dekuNukem/bob_cassette_rewinder/resources/pics/DSCF0456.jpeg

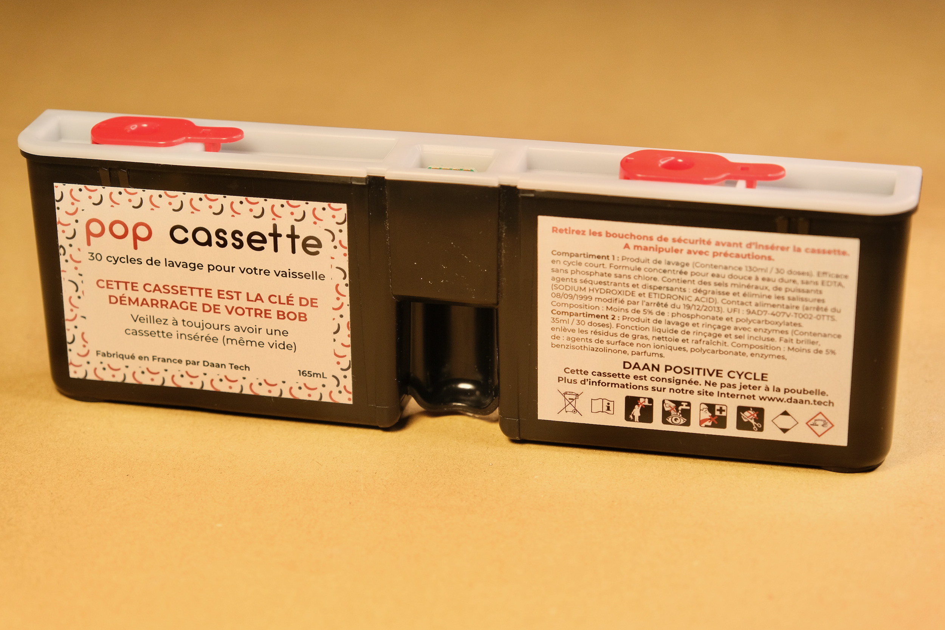
resources/pics/DSCF0456.jpeg
