dekuNukem/bob_cassette_rewinder/resources/pics/cost_2021.png

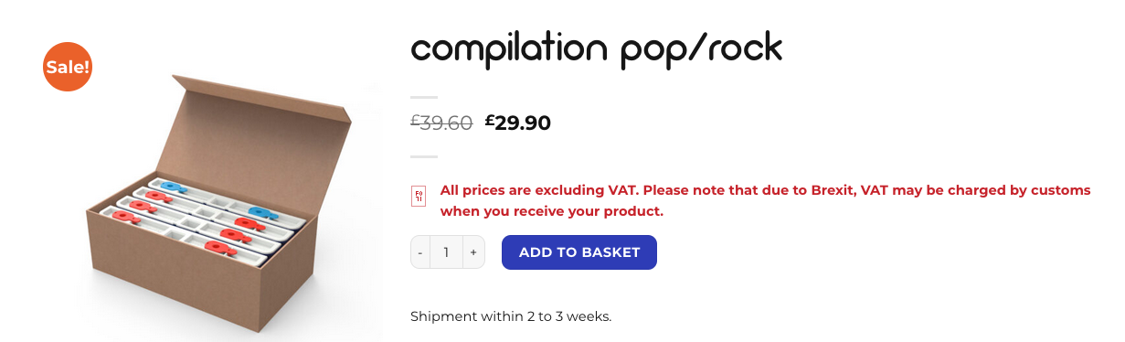
resources/pics/cost_2021.png
