dekuNukem/bob_cassette_rewinder/(threads)

Thread 3 (2021-04-30):

Did you consider writing an EEPROM emulator?

daantimmer, 2021-04-30:
Instead of creating a PCB to reset the EEPROM have you considered using a very small MCU which emulates the EEPROM read/writes while basically always returning the maximum number? That would reduce the number of connector inserts/removals by 50% because those PCB connectors aren't too wear resistant.

ncw, 2021-05-02:
Or maybe modify the board so it enables write protect on the EEPROM?

jangrewe, 2021-05-13:
The one big reason why i would not use any read-only/autoreset feature: you wouldn't know when to refill the casette. I think the current solution is actually the best way.

dekuNukem, 2021-08-09:
> Or maybe modify the board so it enables write protect on the EEPROM?

Well, if you do want to enable Write Protect on the EEPROM, I have tested it out and written a guide about it:

https://github.com/dekuNukem/bob_cassette_rewinder/blob/master/user_manual.md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

Thread 9 (2021-05-04):

Look into Silicon plug or equal to refill by the orginal filling ports

oiaohm, 2021-05-04:
There has been a lot of inkjet cartridge refill over the years.   Pushing hole repeatedly though with a needle with the one way membrane is going to cause it to fail lot sooner just like push the ink back though the foam with printer cartridges.

On inkjets you have the refill/factory fill port on the other side of the cartridge to the outlet normally.    From what I have see of videos/photo of the bob cassette  the two factory filling ports that are now fully plugged are in fact on the other side of the cartridge to the one way membrane and the electronics right out on the corners well away from the electronics.    I know its kind of scary to have to drill 2 holes to put in refill port plugs.   Yes from what I can see of the bob cassette when sitting in the machine the original filling ports will be up so leakage if plugs are not perfect is highly unlikely if they are converted by drilling into refill ports with silicon plugs inserted.

https://www.aliexpress.com/i/32841417076.html
Yes the refill port plugs for inkjet cartridges are mass made.   Yes its possible that if you have a inkjet refill store near that they would do the fitting of the plugs into a bob cassette.   Not like its going to need different drilling set up.  Just they will need to know where on the cassette are the valid locations to put the two holes and unless the cartridge has changed since the photos I can see the locations are really clearly marked as they did not even bother colour matching the closing ports plastic.

Other thing you will find is a cartridge will most likely have a max refill count before some part of it comes a risk to crack or other wise fail.    This is why its important to use refill ports and the like in attempts to make this as many cycles as possible.   Yes the refilling ports are likely to have a stronger band of plastic around it so when filling in the factory if the machine was a little off don't have a breakage.

 The cassettes are similar to inkjet cartridges<<  Yes the i2c DRM on these cassettes are the same as early drm inkjet cartridge.   Some early inkjet cartridges also do use the one way membrane before changing to foam.    So these cassettes are very much early drm inkjet cartridges just filled with dish-washing chemicals.    To be correct inkjet cartridges where the tanks are split from the printer head.  Yes the filling ports of the factory also being really simple to spot is another thing of historic thing of early inkjet cartridges latter generations of inkjet cartridges where they started getting smart with their chips and hiding the correct refill ports.

This could turn into a wacky side job for a shop that does inkjet refills making bob cassettes properly refillable.

lechercheur123, 2021-05-05:
Hi everyone !

I also have a Bob dishwasher (in France ;) ), and I'm not very fond of poking through the silicone plug with a syringe.

I looked at my Bob cassette, and the silicone plugs can be easly removed with fingers (and maybe with gloves for safety) :

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

So I guess you do not need to use specific silicone plug to do what you want

I also found 2 other ports (maybe original refill ports ?), but I broke my nail trying to open one of them :) :

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

dekuNukem, 2021-05-05:
Nicely spotted, I didn't realise that the one-way membrane can be taken off. This certainly makes refilling the cassette easier, although I feel that the same part probably won’t survive many times of removal and insertion, so keeping it in place might make the cassette last longer.

Just a side note, in your photo, it seems that you put the detergent (yellow) in the left tank and rinse aid (blue) in the right, I think it's supposed to be the other way round, or maybe the colour of your detergents is just different? 🤔

lechercheur123, 2021-05-05:
It's very easy to remove the silicone membrane. I don't think removing it hurts the membrane very much.
But you are probably true. This membrane can't last forever. but I think it can last at least 20 or more refilings.

It's an unmodified Bob cassette, so 2 possibilities:
- They use differents detergents
- They mixed things up...

lechercheur123, 2021-05-05:
Side note:

After each wash, the detergent left white stains everywhere in Bob. Do you have the same thing ?

If no, it can be caused by the Bob cassette if detergent and rinse aid are switched

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

dekuNukem, 2021-05-05:
I just tried taking the memberine offI just tried taking the membrane off, it was pretty easy, but I did have to use a pair of pilers to get a better grip. Taking it on and off does seen to put a lot of stress on it though, so I still feel that it won’t last as long compared to “needle poking through membrane” method. The dishwasher itself has hoses poking though it, and they are much bigger.

I looked at a brand new unmodified cassette and drew out some liquid with a syringe. It was indeed a thick blue gel on the left tank, and a clear liquid detergent on right. You can even see the blue colour through the memberine. Not sure why your cassette is the other way 😅 maybe check the others if you have more.

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

As for the water stains, I have some on my lid too after a wash, I think it’s just from hard water.

lechercheur123, 2021-05-05:
> I just tried taking the membrane off, it was pretty easy, but I did use a pair of pilers to get a better grip. Taking it on and off does seen to put a lot of stress on it though, so I still feel that it won’t last as long compared to “needle poking through membrane” method. The dishwasher itself has hoses poking though it, so it should handle a much smaller needle.

I will try both methods when I will have to refil my cassette (I ordered your "rewinder" ;) ). I don't have a syringe yet to "evaluate" the stress it can cause.

> I looked at a brand new unmodified cassette and drew out some liquid with a syringe. It was indeed a thick blue gel in the left tank, and a clear liquid detergent in right. You can even see the blue colour through the memberine. Not sure why your cassette is the other way 😅 maybe check the others if you have more.

I only have one cassette. I will send a little mail to Daan to be sure :)

> As for the water stains, I have some on my lid too after a wash, I think it’s just from hard water.

You are probably right, I have a quite hard water here (588 µS/cm)

oiaohm, 2021-05-08:
lechercheur123  Yes those white hard to remove ports on the back I would suspect would be the original designed location for refilling.   Because that is exactly where they would be if you were using the patent for the early printer cartridges mirrored to make this cartridge.   This item does not look like a new design to me but a old design reused.

It's normal, we changed the formulae  <The common translation to that with ink-jet cartridges was:  "We buy what ever we think is the cheapest that works for us"  I would suspect the same.   Yes this was bad with ink-jet printers when the swapped ink resulted in the complete print fading out of existence in 3 months because of the change.   So refilling yourself may be way to getting more dependable results here.

Yes removing the silicone membrane will shorten it life.

I would be guessing when Daan Tech refils they remove the silicone membrane refill and throws it away and gets a new one.  Not that environmentally friendly.   The fact the design has those extra ports sealed off if they are drill able and plug able that could be the better refill point.

 dekuNukem  I would say if they are drill able and plug-able would be testable on the cartridge you have already cut up so far.

Yes if filling by the silicone membrane by needle or by pulling them out will need new membranes sooner than if you are able to open a the two back ports and turn them into refill ports.

Thread 10 (2021-05-05):

Using an Arduino to reset the counter?

DDanielH, 2021-05-05:
Hi, is it possible to use an Arduino to write the counter on a cassette and if yes are you planning on writing some kind of tutorial?

rubyFeedback, 2021-05-06:
Would be useful to know; I guess the corporations will try to desperately counter the civil rights-to-repair movement, so information in this regard is super-helpful in the long run. And Arduino's are quite accessible even for semi "Average Joe's" (give or take).

dekuNukem, 2021-05-06:
Of course! It's just a bog standard EEPROM inside, and you can use any arduino to read and write it.

Here's a tutorial on sparkfun: https://learn.sparkfun.com/tutorials/reading-and-writing-serial-eeproms/all

dekuNukem, 2021-05-06:
The PCB plugs into a USB-A female socket just fine:

https://raw.githubusercontent.com/dekuNukem/bob_cassette_rewinder/master/resources/pics/pmm.jpeg

the pinouts are, from left to right in that photo on the USB socket, VCC, SDA, SCL, GND

HenrikBiscuit, 2021-05-07:
What will be the easiest way to write to your cassette, if you don't want to take the chance with the import duties from the UK? :D

DDanielH, 2021-05-07:
I hope this is not to mutch to ask, but do you have some example code on how to write the byte at address 0xa1? If i get this right: theoretically I just need to access the EEPROM via i2c and write 0x4e at address 0xa ?

dekuNukem, 2021-05-07:
this should be a decent tutorial: https://microcontrollerslab.com/24c04-two-wire-serial-eeprom-interrfacing-arduino/

A0, A1, A2 are all grounded on bob cassette's EEPROM, so the address should be 0x50.

Someone in the [discord chat](https://discord.gg/gyGFqD2vfP) got it working with an Arduino, so maybe you can try asking there as well.

Thread 11 (2021-05-10):

Commercial Dishwasher Detergent & Rinse Aid for EU Market / German Market?

Xearoxde, 2021-05-10:
Hello everyone,

does someone know where I can get dishwater detergent & rinse aid for the EU Market / German Market? On German Sites I find only b2b offers but nother for customers.

Maybe you know which dealer sells it for non-business customers.

Thanke you.

Xearoxde, 2021-05-12:
Thank you for sharing this. Maybe you can share your results from testing.

jangrewe, 2021-05-13:
I've ordered the Element-brand supplies from Xanchemie in Germany - straight from them instead of Amazon, to save on double shipping and also 5€ on the rinse aid.

http://shop.xanchemie.de/product_info.php?products_id=48
http://shop.xanchemie.de/product_info.php?products_id=46

Although still quite a bit more expensive than UK supplies, the dosage is perfect for the detergent and a bit too high for the rinse aid.

Melanoneiro, 2021-05-17:
@dekuNukem After reading through the conversations on your Discord server and here on github, I think it would be great to have a wiki page here listing detergents people have tried, where to buy them from and what results they achieved with them. If you like I could create a draft for that?

thisisthekap, 2021-06-10:
@dekuNukem @Melanoneiro Yes, that definitely would help a fortune!

PaulCarantonSNCF, 2021-06-10:
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

Hi,

I finally tested the deterged and rince aid I talked about earlier.

I knew that they was much more concentrated than the ones recommended by the author, so I diluted them by a factor 2. I mixed 65mL of detergent with 65mL of water, and I mixed 17mL of rince aid with 17mL of water.

[Security-info-detergent.pdf](https://github.com/dekuNukem/bob_cassette_rewinder/files/6632528/fiche-securite-EXE0312.pdf)
[Security-info-rinse-aid.pdf](https://github.com/dekuNukem/bob_cassette_rewinder/files/6632530/fiche-securite-EXE0314.pdf)

The results was not very good. I had a lot of white powder on my pans after a wash. I guessed it was due to a too high concentration of detergent.

So, I removed 30mL of the detergent mix and replaced it with water. The new mix is now a 1:2.67 dilution ratio of the "pure" detergent.

I don't have white powder on my pans anymore, so I guess 1:2.67 dilution ratio is the good one. For the moment, I will stay with 1:2 dilution ratio for rince aid.

If I do the calculation, it means that my detergent tank will last 30 washes *5000mL / (130/2.67) = 3080 washes (or more than 8 years for 1 wash per day). For the rince aid tank, it's 30 washes  * 5000mL / (35/2) = 8570 washes (or more than 23 years)

If I throw out the rinse aid after 8 years (Is it still efficient after so much years ?), I would have spent 36€ including delivery for 8 years (and 3000 washes). It's 4,5€ per year, or 1,1 cent per wash.

Neat :)

Attention : This is still a WIP. I need to test my dosages for a long time before being sure they are good. Also, for the record, I have a quite hard water at home (Conductivity à 25°C = 629 µS/cm or French TH = 35)

lechercheur123, 2021-06-10:
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

Hi,

I finally tested the deterged and rince aid I talked about earlier.

I knew that they was much more concentrated than the ones recommended by the author, so I diluted them by a factor 2. I mixed 65mL of detergent with 65mL of water, and I mixed 17mL of rince aid with 17mL of water.

[Security-info-detergent.pdf](https://github.com/dekuNukem/bob_cassette_rewinder/files/6632528/fiche-securite-EXE0312.pdf)
[Security-info-rinse-aid.pdf](https://github.com/dekuNukem/bob_cassette_rewinder/files/6632530/fiche-securite-EXE0314.pdf)

The results was not very good. I had a lot of white powder on my pans after a wash. I guessed it was due to a too high concentration of detergent.

So, I removed 30mL of the detergent mix and replaced it with water. The new mix is now a 1:2.67 dilution ratio of the "pure" detergent.

I don't have white powder on my pans anymore, so I guess 1:2.67 dilution ratio is the good one. For the moment, I will stay with 1:2 dilution ratio for rince aid.

If I do the calculation, it means that my detergent tank will last 30 washes *5000mL / (130/2.67) = 3080 washes (or more than 8 years for 1 wash per day). For the rince aid tank, it's 30 washes  * 5000mL / (35/2) = 8570 washes (or more than 23 years)

If I throw out the rinse aid after 8 years (Is it still efficient after so much years ?), I would have spent 36€ including delivery for 8 years (and 3000 washes). It's 4,5€ per year, or 1,1 cent per wash.

Neat :)

Attention : This is still a WIP. I need to test my dosages for a long time before being sure they are good. Also, for the record, I have a quite hard water at home (Conductivity à 25°C = 629 µS/cm or French TH = 35)

KleBoR, 2021-07-07:
hi, any news about the mixtures and/or other products?

Xearoxde, 2021-07-07:
> hi, any news about the mixtures and/or other products?

I bought this:
http://shop.xanchemie.de/product_info.php?products_id=48
http://shop.xanchemie.de/product_info.php?products_id=46

and I don't have mixed them with water. I have very good results.

KleBoR, 2021-07-07:
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

Ah ok. just checked the specs. im just a bit unsure if the dilution. if bob uses 1.x ml of rinse aid per litre and the specs are about 0.1 to 0.5 ml it would be way too much.

thisisthekap, 2021-07-12:
@Xearoxde @KleBoR Has someone done the calculations already how many water we have to add to those to have proper concentration?

KleBoR, 2021-07-13:
@thisisthekap not until now :/

VVincentt, 2021-07-23:
I am in France too and I bought the same products as @lechercheur123 thanks to his recommendation. I do not dilute them and I just refill the cassettes with the pure product. I have very good results, maybe even better than with the original cassettes. The filter in Bob remains clean much longer. My water is very soft, though, as I have a water softerner installed.

I used the detergent in the Rock'n Roll cassette too and it did the job.

lechercheur123, 2021-07-23:
@VVincentt Glad to help you :)
I finished my first refiled cassette yesterday. I will try to use pure detergent too :) (but I have a quite hard water, with a TH around 30°f)

Joel44220, 2021-08-31:
Bonjour la communauté.
Je suis en France.
Je commence à recharger les cassettes.
Personnellement j'utilise les produits suivants  avec succès sauf le détartrant que je n'ai pas encore appliqué.
De plus je vous joins une copie de ma facture. Ce fournisseur est très sérieux, prompt et efficace.
[Facture produits lavage Bob.pdf](https://github.com/dekuNukem/bob_cassette_rewinder/files/7082185/Facture.produits.lavage.Bob.pdf)
[fiche-technique-DETX15.pdf](https://github.com/dekuNukem/bob_cassette_rewinder/files/7082186/fiche-technique-DETX15.pdf)
[fiche-technique-EXE0313.pdf](https://github.com/dekuNukem/bob_cassette_rewinder/files/7082187/fiche-technique-EXE0313.pdf)
[fiche-technique-EXE0314.pdf](https://github.com/dekuNukem/bob_cassette_rewinder/files/7082188/fiche-technique-EXE0314.pdf)

lechercheur123, 2021-08-31:
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

Bonjour Joel44220,

Merci pour ta contribution.

J'utilise les même produits, mais je les paye beaucoup moins cher en les achetant ici :

    detergent : https://eshop.medipost-nutristoma.com/produits/medical/desinfection-hygiene/liquide-de-lavage-exeol-pour-lave-vaisselle-5-litres.html
    rinse aid : https://eshop.medipost-nutristoma.com/produits/medical/desinfection-hygiene/liquide-de-rincage-vaisselle.html

Cependant, ils n'ont pas le détartrant dans leur catalogue.

Pour un bidon de 5L de détergent et de liquide de rinçage, j'en ai eu pour 36€, livraison incluse.

Hi Joel44220,

Thank you for your contribution.

I use the same product as you, but I found them somewhere else cheaper :

    detergent : https://eshop.medipost-nutristoma.com/produits/medical/desinfection-hygiene/liquide-de-lavage-exeol-pour-lave-vaisselle-5-litres.html
    rinse aid : https://eshop.medipost-nutristoma.com/produits/medical/desinfection-hygiene/liquide-de-rincage-vaisselle.html

But the limescale is missing on this website.

For a 5L bottle of detergent and 5L bottle of rinse aid, I paid 36€, including delivery.

bendardenne, 2021-08-31:
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

Attention que la facture contient ton adresse postale.

bendardenne, 2021-08-31:
> @Joel44220 @lechercheur123 @bendardenne
> Guys, could you please have the common decency to keep the conversation in the language that it started in? I'm also not a native english speaker, this is the internet, so please use the common language of the internet.

If you read down you will see that @lechercheur123's comment has an English translation at the bottom. As for my comment, it's addressed to Joel specifically as he (most likely unintentionally) leaked personal data.

I understand the sentiment but no need to be curt.

jangrewe, 2021-08-31:
@bendardenne: I said "please" twice, how's that rude?

lechercheur123, 2021-08-31:
>
>
> @bendardenne: I said "please" twice, how's that rude?

Well, in France saying "avoir la décence de" (tanslation of "have the decency") is quite offensive. But I understand this was not your intention.

I agree with you that this topic should stay in English (as in most forums). But @Joel44220 might not speak English (and he joined Github just before posting his message, so he might not be used to this "unspoken" rule).

That's why I wrote my message in both languages, in order to not offend anyone.

Joel44220, 2021-08-31:
Bonsoir,

Merci pour cette explication.
Je suis outré par ces réactions !!
Je me suis inscrit pour donner des compléments d'information pour les
pays francophones.
Je pensais dialoguer avec des gens respectueux, je me suis trompé.

Veuillez, dans les meilleurs délais, retirer toute trace de mon
intervention et me désinscrire de Github.

Très cordialement.
Joël OLLIVIER

Le Tue, 31 Aug 2021 04:45:15 -0700,
Paul ***@***.***> a écrit :

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

jangrewe, 2021-08-31:
Intentionally ignoring the now-not-unspoken-anymore rule after being asked nicely to make the conversation accessible to everyone, now *that* feels rude... but if my school french is sufficient, that problem will solve itself soon enough.

KleBoR, 2021-10-05:
@jangrewe have you managed the right concentration of those two xanchemie products?

gwynbleidddracke, 2021-11-12:
Hi @lechercheur123 the link are dead, did you have any other link with the same product ? i'm in France too and I struggle to find the good product. can you help me ?

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

PaulCarantonSNCF, 2021-11-13:
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

Hi @gwynbleidddracke !

Medipost changed their website. Here are the new links :
- detergent : https://www.medipost.shop/liquide-de-lavage-exeol-pour-lave-vaisselle-5-litres.html
- rinse aid : https://www.medipost.shop/liquide-de-rincage-pour-utilisation-en-machine-5-litres.html

lechercheur123, 2021-11-13:
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

Hi @gwynbleidddracke !

Medipost changed their website. Here are the new links :

    detergent : https://www.medipost.shop/liquide-de-lavage-exeol-pour-lave-vaisselle-5-litres.html
    rinse aid : https://www.medipost.shop/liquide-de-rincage-pour-utilisation-en-machine-5-litres.html

gwynbleidddracke, 2021-11-13:
Thanks for your help @lechercheur123 !
Now I know what to buy next month.

Thank you :)

KleBoR, 2021-11-21:
@Xearoxde how is it working with the pure rinse aid you bought?

What are you using for the rock&roll cartridge?

koffeinvampir, 2021-12-02:
>

I was wondering the same! The reset seems to work, but I have not found the composition of the de-scaler.

koffeinvampir, 2021-12-02:
> @Xearoxde how is it working with the pure rinse aid you bought?
>
> What are you using for the rock&roll cartridge?

I was wondering the same! The reset seems to work, but I have not found the composition of the de-scaler.

daveyijzermans, 2021-12-09:
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

So am I understanding correct that these two products are the perfect concentration for filling up the cassette? They don't need any additional preparing, diluting? I could buy these, fill up the cassette and use the rewinder?

LukasP, 2022-08-14:
I've been using the medipost detergent and rinse aid for a while now, it's not perfect but about as good as I remember from the original cassettes. I'll share what concentrations I use in case anyone's looking for another data point:

I use the detergent undiluted.
Manufacturer recommends 2.5-4g/L for my water hardness, Bob uses 4.33mL per liter, close enough imo.

For the rinse aid: 12mL rinse 23mL water
Manufacturer recommends 0.3-0.4g/L
Bob uses 1.17mL to 1.2L water, roughly 1g/L
I started with 2/5 or 14mL rinse 21mL water per refill, about 0.4g/L, which left some white residue.
Next refill used 12mL rinse to 23mL of water which should be about 34% or about 3.4g/L
White residue is almost gone but I remember getting a little of that with the original cassettes as well.

nyancrimew, 2022-08-19:
FYI for anyone from switzerland, while xanchemie doesn't list switzerland on their order form you can email them to order anyways, shipping is quite steep but not as bad as i expected

Thread 13 (2021-07-04):

Rock and Roll Cartridge, Tank 2

Hawk-v3, 2021-07-04:
While I can't find the EXACT product, my googlefu is failing me, the other tank appears to be something like this:

https://www.kiilto.com/product/f-60-ciro/#compositions

However the formulation doesn't match exactly, it has citric acid in it as well.

Dosage would be 35ml in a currently unknown amount of water.

The packaging details:
35ml/1 dose.
UFI: CM57-N0DW-W00G-D6CR
Composition: Methanesulfonic Acid

miyoyo, 2022-03-14:
Here are the exact specifications, you can use this website to get the formulation number:
https://www.decoder-ufi.com/ufi.aspx

The two formulations are:
 - Tank 1: P7D7-M0JG-G00K-AG7Q, Formulation 2670
 - Tank 2: CM57-N0DW-W00G-D6CR, Formulation 2593
Both are from SAS SODEL, www.sodel-sa.eu

When looking at the safety documents on the website, it appears that they use this specific format:

```
1.1. Product identifier
Product name : DPC 600
Product code : FS CLP2593.
```

So, looking for "FS CLP2670 filetype:pdf" gives us [this safety document.](https://www.avanteamgroup.com/docs/2621-4273-LIQUIDE%20VAISSELLE%20LLV200-.pdf)
Copy here: [2621-4273-LIQUIDE VAISSELLE LLV200-.pdf](https://github.com/dekuNukem/bob_cassette_rewinder/files/8246348/2621-4273-LIQUIDE.VAISSELLE.LLV200-.pdf)

So, the Bob Cassette Rock'N'Roll has:
 - Tank 1: [Sodel/Exeol LLV200](https://www.sodel-sa.eu/produit/EXEOL/LLV200/Liquide-Lavage-Vaisselle-eau-douce-a-dure-Ecolabel)
 - Tank 2: [Sodel/Exeol DPC600](https://www.sodel-sa.eu/produit/EXEOL/DPC600/Detartrant-Puissant-Concentre-Eco-optimise)

miyoyo, 2022-03-14:
And just because I can (sorry for the off topic part)

Pop Cassette:
- Tank 1: [Sodel/Exeol LLV300](https://ruedelhygiene.fr/wp-content/uploads/woocommerce_uploads/2020/09/Fiche-securite-LD2000S-awgfs5.pdf), ([Copy)](https://github.com/dekuNukem/bob_cassette_rewinder/files/8246394/Fiche-securite-LD2000S-awgfs5.pdf), 9AD7-407V-T002-0TTS, bleach based
- Tank 2: Not certain, however there is [this specific document in the safety sheets of Daan Tech](https://github.com/dekuNukem/bob_cassette_rewinder/files/8246424/FinalA_PSDS_D8168834-EU_Dish_Gel_2019_RTRID-11340.pdf), which refers to an off the shelf Finish All in One gel product, which is enzyme based.

Coincidentally, I was watching [Technological Connections](https://youtu.be/Ll6-eGDpimU?t=1580), which explains that Enzymes and Bleach do not mix in gels, which is probably why the cassettes are using detergent twice, and not something like dedicated rinse-aid.

dekuNukem, 2022-03-14:
Thanks! I'll add those information to the main articles.

hezibu, 2024-01-05:
Great work! Really appreciated.

Are the detergent specified by @miyoyo the final conclusion on what to refill each tank of the two cassettes?
That's amazing.

hezibu, 2024-01-05:
@miyoyo  Thanks for the quick reply.

I just got mine yesterday. I'm inclined for refills over tabs because I used to have tabs for my full size dishwasher, so I guess it's somewhat of an overkill with this small one.
How is your experience with tabs?

miyoyo, 2024-01-05:
You need to use different quantities depending on how hard your water is, I use a full tab myself

Thread 15 (2021-08-02):

Write protect on the EPROM

chiisai-fukurou, 2021-08-02:
Hi, I’ve looked at the documentation of the EPROM and saw that it has a write protect pin.

Did you try out connecting the WP pin to Vcc?

I want to try and connect the detergent tanks directly to the internal dosage pumps of bob to avoid having to refill the cassettes.
I’d still need the EPROM of the Cassette to get it to work tho.
So my train of thought is that Bob couldn’t modify the value on the EPROM anymore, reading the same number of cycles every time.

Also sorry if im getting things wrong… it’s been quite a few years since I worked on anything electronic :|

Thanks anyways :)

dekuNukem, 2021-08-09:
Here's the description of the write protect (WP) pin:

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

and here is how it is wired up on the circuit board:

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

You can see that it is connected to the ground plane UNDER the chip, which disables the write protect, allowing the EEPROM to be written to.

If you want to enable the WP again, you would need to either:

* Bend the pin upwards so it's not touching the pad, or...
* Desolder the chip, cut the connection to the ground plane, solder it back on

Then, you can connect that pin to VCC, which should then enable the write protect.

I haven't tried it myself, but it would be interesting to see what happens.

dekuNukem, 2021-08-09:
Good news! I have tested out the Write Protect, and it works! The wash count will be frozen, and Bob still works.

I have written a guide, check it out here:

https://github.com/dekuNukem/bob_cassette_rewinder/blob/master/user_manual.md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

bendardenne, 2021-08-09:
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

Excellent news ! I will try this with my current cassette once it runs out.

Couldn't they update the software to refuse the cassette if the eeprom cannot be written? I would probably disable over-the-air updates if I used this approach, what do you think?

dekuNukem, 2021-08-09:
It's definitely a good idea to keep it offline. There'ss no reason for a dishwasher to be online anyway, especially now it can be refilled! 😅

Thread 16 (2021-08-04):

Tindie's custom fees in the EU

bendardenne, 2021-08-04:
Hello,

First, thanks for all the work!

Unfortunately, Tindie's does not collect VAT at ordering, and so if you order from the EU you will (probably??) need to pay VAT yourself, along with hefty processing fees (I assume because of the new import rules that came in effect July 1st).

I don't know how easy it would be to find a platform which complies with EU VAT rules, but I think it would be good to mention this, here on GitHub and/or on Tindie's to avoid surprises for people like me who may not realize they are ordering from abroad :). Especially since a lot of people with Bobs are probably French.

I had to pay 21€ to the Belgian post in VAT and processing fees to receive the chip :(

dekuNukem, 2021-08-16:
Sorry to hear about the VAT fee, 21€ is a bit outreageous, that's almost the cost of this device!

Anyway, I have made some changes to the custom documents, and added more detailed decription of the product, hopefully it will make them happier.

bendardenne, 2021-10-08:
If I understood correctly, there's no amount of description that can bypass this, unfortunately. The shop would need to charge VAT and then somehow pay it back to "the EU" (I guess the destination country?? no idea how this works). Some info here: https://www.bpost.be/en/shopping-outside-eu

What's outrageous is that 15€ flat processing fee that bpost charges. For people in other countries, it would be cheaper. Anyway, it's still a reasonable price given the amount I will save in the end, and the result is much better than if I soldered something myself, given my poor skills and the limited hardware I have at home.

Closed 2021-10-08.

Thread 18 (2021-11-13):

Connector pinhead interface

BastienClermont, 2021-11-13:
Hi, I wanted to make myself a bob cassette rewinder as a project to practice my home-made pcb skills. However I can't find what type of connector you use on your custom PCB to interface with the cassette EEPROM. I'm talking about the one named JP1 (PINHEAD_2X04) on the schematics. As I understand using a female USB-A connector would short the pads on the cassette, so it has to be plastic.

Thanks!

BastienClermont, 2021-11-13:
Hi again,
I just found it! It's called a Card Edge Connector and the one that fits is called [SA08BL01D](https://www.lcsc.com/product-detail/Wire-To-Board-Wire-To-Wire-Connector_UMAX-SA08BL01D_C601198.html) from UMAX.
Thanks @dekuNukem for this great project/hack !

Closed 2021-11-13.

Thread 20 (2022-01-30):

Working in 2022?

Tangeek42, 2022-01-30:
Hi !

I'm considering trying out this bob business, but I'd like to make sure. As of January 2022, have there been any update preventing the hack ? Obviously I'll never connect the device to my network, but I'm worried they patched the product on shelves.

Sorry if there was the info somewhere, I read your manual, but could have missed it.

dekuNukem, 2022-01-30:
Hi there! I'm fairly certain that they haven't patched it. Mine is still working, and I haven't heard any issues from the existing users.

Tangeek42, 2022-01-30:
Oh wow, such a quick reply. I was hesitating jumping the gun tonight haha.
I'll take the risk, then. I'll come back to confirm once I get everything.

And in case I forget, thank you already for the hack and for taking the time to explain "basic" stuff in your readme. I didn't have the first clue as to what to look for regarding the detergent. ^^

KleBoR, 2022-02-25:
@Tangeek42 have you updated your bob to the latest fw? would be nice to hear if it still works =)

Tangeek42, 2022-03-22:
I can confirm it still works on 8.0.1, which was the latest firmware a month ago. :)

Eric-Poussin, 2022-08-11:
Hi all,
FYI I received my bobrewinder today and I confirm that it always work with latest firmware at this date: 9.0.1 :-)

And big thanks for this hack

KleBoR, 2022-08-11:
Thank you @Eric-Poussin for the update. So ill push my bob to the latest fw ;)

polyarmid, 2022-08-20:
Hi - how do you update the bob ?

Eric-Poussin, 2022-08-20:
> Hi - how do you update the bob ?

Just connect it to my Daan-tech account (and disconnect just after, I'm not comfortable with permanent link of a simple dishwasher !!)

But I don't know if there is any advantage to keep it updated ?!
I hope that Daan tech made an update for chosing to use product in the cassette ...or not. For any cycle or just one.
Perhaps I'll have more chance by waiting alternate firmware ;-) ;-)

Thread 21 (2022-04-13):

Reverse Engineering of Bob (including backup of ESP flash)

whosmatt, 2022-04-13:
My Bob (normal version) arrived today and I could not help but take it apart immediately (at least the front plate).
I'll share my findings here, because some of them are very relevant to the project.

The front panel is very easy to take apart, just remove the screws visible from the inside. There are four (non evil) clips holding the front plastic down around the window, those will come undone by applying a bit of force and rocking the front plastic around from the top (there is no way to directly undo the clips, but they are designed to pull out without damage). There is a hinge at the bottom, so do not pry from the bottom.

Having done that, you will be greeted by a small board (rev 2.4 in my case) with an ESP32-WROOM-32D (Detected as ESP32-D0WD (revision 1)) and a handful of peripherals. Notably, the connection to the power electronics somewhere else in the unit happens via a single standard RJ45 cable.
There is a handy programming header for the ESP, I have marked the pinout in the picture below.
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

I used esptool to dump the firmware (esptool detects 16MB flash). I am no firmware dumping expert, I cannot guarantee that this file is valid and wont brick your Bob. Flashing it to a random 8MB ESP32 does seem to give the correct serial output, but doesnt find all the partitions. I sadly do not have a 16MB ESP around to test it properly.
[BobOS_hwrev24.zip](https://github.com/dekuNukem/bob_cassette_rewinder/files/8484681/BobOS_hwrev24.zip)

Now for the most interesting bit: The serial dump. Bob is VERY talkative when just connected to a 115200 baud serial interface. Maybe a little too talkative because it includes wifi ssid and password in cleartext. Here is a somewhat full serial log with personal information [REDACTED]: [Bob_serial_log.txt](https://github.com/dekuNukem/bob_cassette_rewinder/files/8484756/Bob_serial_log.txt)

It seems to be communicating to an AWS backend using MQTT. Alarmingly, there is no privacy policy available for this particular service and there are some hints towards the bottom of the log that it **might be sending cartridge info to the server**.
**If that is the case, they may be able to see if cassettes have been rewound.**

Regardless, they are able to fight the rewinder with OTA updates, so keeping wifi disconnected might be the best option. Until someone takes the risk and tries it, we dont know if downgrading by flashing the ESP works.

whosmatt, 2022-04-13:
After a couple hiccups with wifi (stayed on the update screen for a long time) my Bob seems to be working again, so booting it on the bench (without its peripherals connected) did not lock up the software.

There are hints towards an STM32 MCU on the power board somewhere else in the machine. The ESP seems to have a partition with a binary for an STM32 processor, presumably for updating it.

I dont think I am goig to take apart the full machine though. I am happy enough having dumped the firmware and taking apart the rest would get messy and complicated.

The 2 pin connector seen on the PCB is for the touch strip that opens the door.

miyoyo, 2022-04-13:
Hey there, you may want to join us on Discord, we've been working with the Bob Minimalist and I've been sharing my findings there, maybe there are a few things you can pick up with some quick discussion.

dekuNukem, 2022-04-13:
Nice job! The discord link is here: https://discord.gg/gyGFqD2vfP

miyoyo has made a lot of progress on a bob minimalist, and did some firmware disassembly too!

EmerickH, 2023-03-19:
Hey, I did some work figuring the layout of the board
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

GPIO | Description
-- | --
GPIO0 | External (clock out?)
GPIO1 | Serial TX
GPIO2 | Audio amplifier shutdown control
GPIO3 | Serial RX
GPIO4 | Screen power control
GPIO5 | RS485 DIR
GPIO12 | N.C. ?
GPIO13 | Screen data?
GPIO14 | LED power control
GPIO15 | Screen data?
GPIO16 | Screen data?
GPIO17 | Screen data? Also layed out to RJ45
GPIO18 | Screen data?
GPIO19 | Screen data?
GPIO21 | Layed out to RJ45
GPIO22 | RS485 RX
GPIO23 | RS485 TX
GPIO24 | N.C. ?
GPIO25 | N.C. ?
GPIO26 | Layed out to RJ45
GPIO27 | Touch sensing
GPIO32 | Button 1
GPIO33 | Layed out to RJ45
GPIO34 | Button 3
GPIO35 | Button 2

2 of the pins going in the RJ45 are probably i2c for the cartridge, the others maybe for LEDs?

With that kind of info and a little bit of figuring out the protocol with the power board we should be able to make a completely custom firmware

robbe-haesendonck, 2023-10-22:
@whosmatt
FYI:
You unintentionally leaked your WiFi credentials by sharing the binary dump.

whosmatt, 2023-10-22:
> @whosmatt FYI: You unintentionally leaked your WiFi credentials by sharing the binary dump.

don't worry, I was aware of that right after posting it and had changed them immediately

Thread 24 (2022-06-08):

I get a banner from GitHub for this repo when I open my own repositories

ReagentX, 2022-06-08:
This issue isn't with this repo, I just found it amusing.

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

dekuNukem, 2022-06-08:
That’s pretty funny😅 Wonder how much free exposure it got from this.

dekuNukem, 2022-06-08:
Have you seen or interacted with this repo before, or is it the first time you heard of it 🤔?

Closed 2022-06-23.

Thread 25 (2023-05-24):

Hardware connector issue

IFroozy, 2023-05-24:
Hello
have you some reference of connecteur usable on this project ?
i need to replace my broken one but i can’t find the same or for very high price

brambo123, 2023-10-18:
When I look at the circuit board drawing, it is just a .1" by .2" pin spacing.
I wanted to make a printed circuit board myself and ordered some connectors from Aliexpress.
Will let you know if they fit and work well.

Thread 26 (2023-10-01):

UK recommended detergents are not working

CelesteJA, 2023-10-01:
I bought and tried the detergents recommended by the creator of this wonderful rewinder, but they just simply don't clean my dishes.
Seems to work okay on non-stick pans, but plates and cutlery are being left with food smears stuck to them.

I noticed there's a difference in PH levels between the original bob formula and the recommended replacement; the original bob formula has a PH 1, whereas the recommended replacement has PH 2. Not sure if that's the reason it's just not cleaning my dishes?

Has anyone had any luck finding a good replacement detergent and rinse aid in the UK? I'm pulling my hair out over this, I've been searching for ages.

dekuNukem, 2023-10-01:
Hi there! first make sure the detergent piping is not blocked. i have read reports that the detergent dries up or crystallizes in the pipe and blocking it, and you end up with no detergent delivery at all.

maybe weigh the cassette, do a few washes and weigh it again to make sure it actually got lighter.

you can also try adding the 4mL of detergent directly into the tub and do a wash, if it’s noticeably cleaner that way, then something might be wrong with the delivery.

also make sure the heating plate is working, the inside should be hot after a wash.

CelesteJA, 2023-10-01:
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

Hello! Thanks for the quick response!

At the risk of sounding ignorant, where is the detergent piping located? And by tub, do you mean the tank where I pour the water (the holes at the top of Bob)? Or the area where I put the dishes?

The heating plate seems to work fine thankfully, as the dishes and inside are hot when the cycle is done.

dekuNukem, 2023-10-01:
the tube is where the detergent from the cassette is drawn from, it is under the flip-out door and normally not visible, so i suggested that doing a few washes and see if the weight changes. if not, then the detergent isn't coming out and something is wrong with the tube, or maybe the detergent pump too.

the tub is the main compartment where you put in the dishes.

CelesteJA, 2023-10-01:
> the tube is where the detergent from the cassette is drawn from, it is under the flip-out door and normally not visible, so i suggested that doing a few washes and see if the weight changes. if not, then the detergent isn't coming out and something is wrong with the tube, or maybe the detergent pump too.
>
> the tub is the main compartment where you put in the dishes.

Thanks very much!
I'll respond again once I've conducted the tests.

CelesteJA, 2023-10-02:
> the tube is where the detergent from the cassette is drawn from, it is under the flip-out door but just wanted to add and normally not visible, so i suggested that doing a few washes and see if the weight changes. if not, then the detergent isn't coming out and something is wrong with the tube, or maybe the detergent pump too.
>
> the tub is the main compartment where you put in the dishes.

Hi again, I haven't conducted the tests yet, but just wanted to add some more info that I'd forgotten about.
I have noticed that the dishes are being left with a lot of white "stains" or "powder" on them after each wash, alongside not getting the food off the dishes properly. I don't know if that information changes or narrows down what the problem could be?

CelesteJA, 2023-10-04:
> the tube is where the detergent from the cassette is drawn from, it is under the flip-out door and normally not visible, so i suggested that doing a few washes and see if the weight changes. if not, then the detergent isn't coming out and something is wrong with the tube, or maybe the detergent pump too.
>
> the tub is the main compartment where you put in the dishes.

So I've done the tests, the detergent seems to be dispensing all right, so I decided to try putting the detergent directly into the tub, like you suggested, to see if it would help, but got even worse results (more white powder and food left all over the dishes).
Afterwards I did another cycle, this time putting in a bob dishwasher tablet that I got sent with the unit. The dishes came out sparkling clean.
I don't understand why this detergent isn't working for me?

brambo123, 2023-10-18:
The recommended detergent is from the time when it was not yet known what kind of detergent it actually contained.
It is now known that it contains Sodel LLV300.
It contains between 10 and 25% sodium hydroxide and has a pH value of 13.5.
The one initially recommended had 1 to 5% sodium hydroxide and a pH 14.
So a product with a pH 2 is completely different.
I'm wondering what kind of product you have and how you determined the pH value.

Thread 27 (2023-10-13):

Manufacturer changed detergent?

brambo123, 2023-10-13:
I just ordered a Bob and was trying to figure things out.
I came across this page:
https://daan.tech/eur/discover-bob-cassette/safety-data-sheet/

If you look at the first safety sheet it looks like they are now using an all in one gel from Finish.
So they may have switched to a different detergent.

The 2nd safety sheet is for EXEOL/SODEL DPC 600, a descaling product.
If I google it, you have to use this in an empty machine.
So this will be what is now in the rock'n'roll cassette.

It would not surprise me that the eeprom is not only used to count, but also to indicate how much detergent should be used.
So the contents of the EEPROM may now be different.

When I get my Bob in a few weeks, I would like to try making a dump of the EEPROM to see if there is a difference.

brambo123, 2023-10-24:
In the meantime I have received my Bob.
But still with the old cleaning agent.
Still, I did make a few dumps.
It looks like they are now using even less data than before.

At the beginning of the memory is a UUID (Universally unique identifier).
The normal format is 8-4-4-4-12 characters.
In previous dumps the beginning was a bit strange.
Now it is complete and the same in both the rock and the pop cassette.

Pop cassette:
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
Rock'n'roll cassette:
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

miyoyo, 2023-11-22:
See link: https://github.com/dekuNukem/bob_cassette_rewinder/issues/13#issuecomment-1066973934

It's been the same for a while, just that the main readme isn't up to date.

brambo123, 2024-02-25:
> See link: [#13 (comment)](https://github.com/dekuNukem/bob_cassette_rewinder/issues/13#issuecomment-1066973934)
>
> It's been the same for a while, just that the main readme isn't up to date.

That's exactly why I say they may have started using different dishwasher detergent.
It was Sodel/Exeol LLV200, which I also received.
But new safety sheet indicates Finish All in 1 Max Gel

Since they indicate Finish gel, I tried that.
That's easy to get through Amazon.
Been using that for a while now and it works fine.
Since it is an all-in-one product, I filled the part for rinse aid with water.

miyoyo, 2024-02-25:
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

It's both.

The bigger compartment has llv200, the smaller has finish all In one.

See: https://github.com/dekuNukem/bob_cassette_rewinder/issues/13#issuecomment-1066973934

Madhippy24, 2024-10-07:
Struggling to fill the cassette with the Finish gel as it's a bit thick,  Any suggestion on needle size .  I can see they go to 10 gauge but i don't want to damge the membrane

brambo123, 2024-10-07:
> Struggling to fill the cassette with the Finish gel as it's a bit thick, Any suggestion on needle size . I can see they go to 10 gauge but i don't want to damge the membrane

I simply pop out the entire membrane.
And then I fill it directly from the bottle.
It may take some practice, but it is perfectly doable.

The only difficult thing I find is to fill it completely.
Part of the container is on the other side of the finger grip/PCB connector.
It does not flow there so easily because of the thickness.
So I put it down at an angle and give it quite some time.
After a few refills it is then quite full.

Madhippy24, 2024-10-07:
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

Thank you .  Simple pair of long nose pliers or prise open with something flat ?

brambo123, 2024-10-07:
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

Long nose pliers will work.
I simply use the tip of a table knife (a blunt one of course)
You should not only pull, but also push the edge inwards a little.
This will free the raised edge on the inside to come up.
Luckily the edge of the membrane is quite thick and won't break easily.

Madhippy24, 2024-10-07:
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

Thank you for you advice :) appreciated
