dekuNukem/bob_cassette_rewinder/pcb/pmm.brd

## EAGLE design pcb/pmm.brd (2025-05-12)

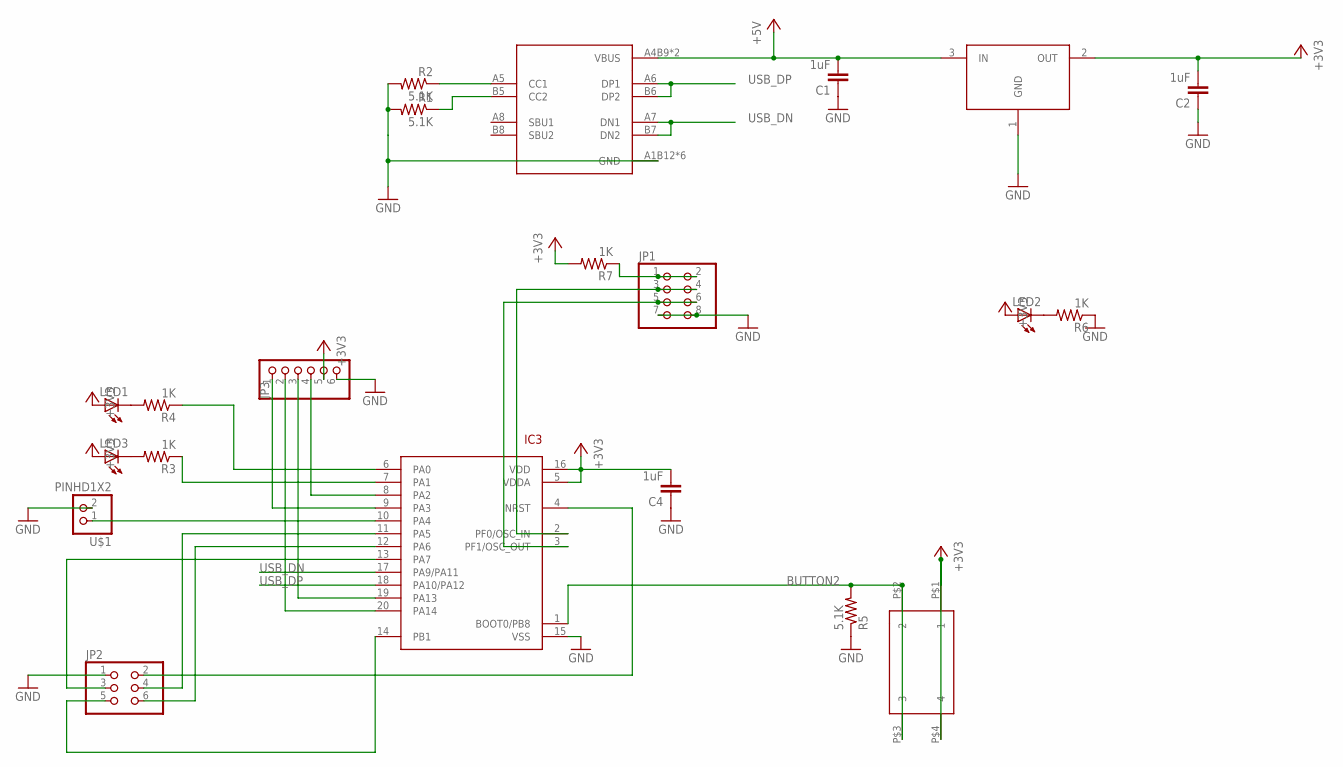
[picture p49: schematic pmm.sch]

Parts:
C1, C2, C4: 1uF; 0805@1
IC3: STM32F042F4; TSSOP20
JP1: PINHEAD_PINHD-2X4; PINHEAD_2X04
JP2: PINHD-2X3; 2X03
JP3: PINHD-1X6; 1X06
LED1, LED2, LED3: LEDCHIP-LED0805; CHIP-LED0805
R1, R2, R5: 5.1K; 0805
R3, R4, R6, R7: 1K; 0805
SW4: 324_SW; 342_SWICH_FOOT
U2: USBC_16P; USBC_16P_FOOT
U4: XC6206_DEV; SOT23R_INFINEON
U$1: PINHD1X2; 1X02

Connections:
+3V3: C2.2, C4.2, IC3.5 (VDDA), IC3.16 (VDD), JP3.5, LED1.A, LED2.A, LED3.A, R7.2, SW4.P$1 (1), SW4.P$4 (4), U4.2 (OUT)
+5V: C1.2, U2.A4B9 (VBUS), U2.B4A9 (VBUS), U4.3 (IN)
BUTTON2: IC3.1 (BOOT0/PB8), R5.2, SW4.P$2 (2), SW4.P$3 (3)
GND: C1.1, C2.1, C4.1, IC3.15 (VSS), JP1.7, JP1.8, JP2.1, JP3.6, R1.2, R2.2, R5.1, R6.1, U2.A1B12 (GND), U2.B11A12 (GND), U2.P$13 (GND), U2.P$14 (GND), U2.P$15 (GND), U2.P$16 (GND), U4.1 (GND), U$1.2
unnamed: LED3.C, R3.2
unnamed: IC3.2 (PF0/OSC_IN), JP1.3, JP1.4
unnamed: IC3.20 (PA14), JP3.2
unnamed: IC3.19 (PA13), JP3.3
unnamed: LED1.C, R4.2
unnamed: IC3.8 (PA2), JP3.4
unnamed: IC3.9 (PA3), JP3.1
unnamed: IC3.6 (PA0), R4.1
unnamed: IC3.7 (PA1), R3.1
unnamed: JP1.1, JP1.2, R7.1
unnamed: IC3.11 (PA5), JP2.4
unnamed: IC3.12 (PA6), JP2.6
unnamed: IC3.13 (PA7), JP2.3
unnamed: IC3.14 (PB1), JP2.5
unnamed: IC3.4 (NRST), JP2.2
unnamed: IC3.10 (PA4), U$1.1
unnamed: LED2.C, R6.2
unnamed: R1.1, U2.B5 (CC2)
unnamed: R2.1, U2.A5 (CC1)
SCL: IC3.3 (PF1/OSC_OUT), JP1.5, JP1.6
USB_DN: IC3.17 (PA9/PA11), U2.A7 (DN1), U2.B7 (DN2)
USB_DP: IC3.18 (PA10/PA12), U2.A6 (DP1), U2.B6 (DP2)

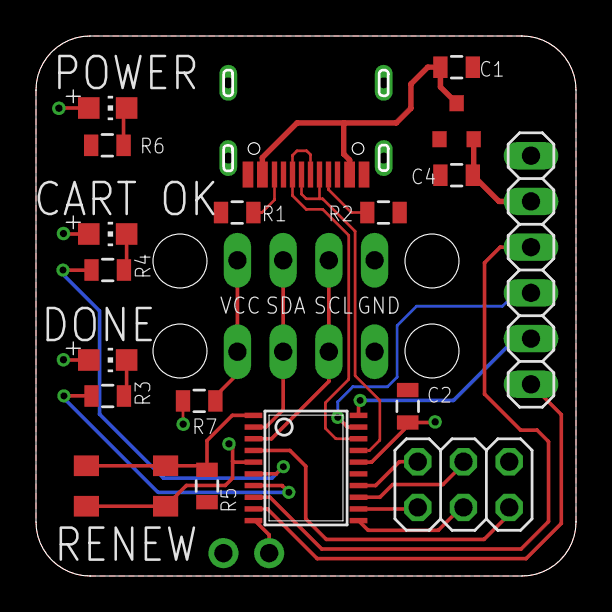
[picture p50: board pmm.brd from above]

Board: 2 copper layers, 30.0 x 30.0 mm, 21 parts (0 on the bottom side), 26 nets.
