dekuNukem/bob_cassette_rewinder/firmware/code/Src/main.c

/**
  ******************************************************************************
  * @file           : main.c
  * @brief          : Main program body
  ******************************************************************************
  * This notice applies to any and all portions of this file
  * that are not between comment pairs USER CODE BEGIN and
  * USER CODE END. Other portions of this file, whether 
  * inserted by the user or by software development tools
  * are owned by their respective copyright owners.
  *
  * Copyright (c) 2021 STMicroelectronics International N.V. 
  * All rights reserved.
  *
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
  ******************************************************************************
  */
/* Includes ------------------------------------------------------------------*/
#include "main.h"
#include "stm32f0xx_hal.h"
#include "usb_device.h"

/* USER CODE BEGIN Includes */
#include <stdio.h>
#include <string.h>
#include "helpers.h"
#include "shared.h"
#include "my_usb.h"
/* USER CODE END Includes */

I2C_HandleTypeDef hi2c1;

IWDG_HandleTypeDef hiwdg;

TIM_HandleTypeDef htim17;

UART_HandleTypeDef huart2;

/* USER CODE BEGIN PV */

#define POP_CASSETTE 0
#define ROCK_CASSETTE 1
#define UNKNOWN_CASSETTE 2

volatile uint8_t is_done;
uint8_t sig1, sig2, cassette_type;

/* USER CODE END PV */

void SystemClock_Config(void);
static void MX_GPIO_Init(void);
static void MX_USART2_UART_Init(void);
static void MX_I2C1_Init(void);
static void MX_TIM17_Init(void);
static void MX_IWDG_Init(void);

/* USER CODE BEGIN PFP */

/* USER CODE END PFP */

/* USER CODE BEGIN 0 */

void set_version(void)
{
    fw_version_major = 0;
    fw_version_minor = 1;
    fw_version_patch = 1;
}

int fputc(int ch, FILE *f)
{
  my_usb_putchar((uint8_t)ch);
  HAL_UART_Transmit(&huart2, (unsigned char *)&ch, 1, 100);
  return ch;
}

// this happens every 250ms
void HAL_TIM_PeriodElapsedCallback(TIM_HandleTypeDef *htim)
{
  if(is_busy)
    return;
  i2c_scan_result = HAL_I2C_IsDeviceReady(&hi2c1, EEPROM_READ_ADDR, 1, 50);
  // printf("%d\n", i2c_scan_result);
}

/* USER CODE END 0 */

/**
  * @brief  The application entry point.
  *
  * @retval None
  */
int main(void)
{
  /* MCU Configuration----------------------------------------------------------*/

  /* Reset of all peripherals, Initializes the Flash interface and the Systick. */
  HAL_Init();

  /* Configure the system clock */
  SystemClock_Config();

  /* Initialize all configured peripherals */
  MX_GPIO_Init();
  MX_USART2_UART_Init();
  MX_I2C1_Init();
  MX_USB_DEVICE_Init();
  MX_TIM17_Init();
  MX_IWDG_Init();
  /* USER CODE BEGIN 2 */
  set_version();
  HAL_Delay(500);
  printf("\n\nBob cassette rewinder\n");
  printf("dekuNukem 2021\n");
  my_usb_init();
  i2c_scan_result = 1;
  HAL_TIM_Base_Start_IT(&htim17);
  /* USER CODE END 2 */

  /* Infinite loop */
  /* USER CODE BEGIN WHILE */

  while (1)
  {
    if(i2c_scan_result != 2)
      HAL_IWDG_Refresh(&hiwdg);

    parse_cmd(my_usb_readline());

    if(i2c_scan_result == 0) // if cassette is found 
    {
      HAL_GPIO_WritePin(LED_CARTOK_GPIO_Port, LED_CARTOK_Pin, GPIO_PIN_RESET); // turn on CART_OK LED
    }
    else // if no cassette detected
    {
      // turn off both CART_OK and DONE LED
      HAL_GPIO_WritePin(LED_CARTOK_GPIO_Port, LED_CARTOK_Pin, GPIO_PIN_SET);
      HAL_GPIO_WritePin(LED_DONE_GPIO_Port, LED_DONE_Pin, GPIO_PIN_SET);
      is_done = 0;
    }

    // if DONE button is pressed
    uint8_t button_result = HAL_GPIO_ReadPin(USER_BUTTON_GPIO_Port, USER_BUTTON_Pin);
    if(i2c_scan_result == 0 && button_result == 1 && is_done == 0)
    {
      sig1 = eeprom_read(0x90);
      sig2 = eeprom_read(0x98);

      if(sig1 == 0x43 && sig2 == 0x65) // Classique
        cassette_type = POP_CASSETTE;
      else if(sig1 == 0x45 && sig2 == 0x6e) // Classique
        cassette_type = ROCK_CASSETTE;
      else
        cassette_type = UNKNOWN_CASSETTE;

      if(cassette_type == UNKNOWN_CASSETTE) // flashes CART OK LED and exit
      {
        for (int i = 0; i < 21; ++i)
        {
          HAL_GPIO_TogglePin(LED_CARTOK_GPIO_Port, LED_CARTOK_Pin);
          HAL_IWDG_Refresh(&hiwdg);
          HAL_Delay(100);
        }
        continue;
      }

      if(cassette_type == POP_CASSETTE)
        eeprom_write(0xa1, 0x4e); // 30 washes
      else if (cassette_type == ROCK_CASSETTE)
        eeprom_write(0xa1, 0x51); // 1 wash
      HAL_GPIO_WritePin(LED_DONE_GPIO_Port, LED_DONE_Pin, GPIO_PIN_RESET);
      is_done = 1;
    }

    
  /* USER CODE END WHILE */

  /* USER CODE BEGIN 3 */

  }
  /* USER CODE END 3 */

}

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
