dekuNukem/bob_cassette_rewinder/bin_dump/bob_dump.py

import sys
import time
import serial
from datetime import datetime

def iso8601_utc_now():
    ret = datetime.utcnow().isoformat(sep='T')
    return (ret[:19] + "Z").replace(':', '-')

if(len(sys.argv) < 2):
    print(__file__ + ' serial_port')
    exit()

print("Opening", sys.argv[1], '...')

ser = serial.Serial(sys.argv[1], 115200)

bin_dict = {}

ser.write("dump\n".encode())

while 1:
    this_line = ser.readline().decode('utf-8')
    print(this_line)
    if 'done' in this_line.lower():
        break
    if 'dump' in this_line:
        addr = int(this_line.split(' ')[1])
        data = int(this_line.split(' ')[2])
        bin_dict[addr] = data

ser.close()

if len(bin_dict) != 256:
    print('Wrong size! exiting...')

byte_list = []
for i in range(len(bin_dict)):
    byte_list.append(bin_dict[i])

byte_str = ''
for item in byte_list:
    if 32 <= item <= 126:
        byte_str += chr(item)
    else:
        byte_str += ' '

print(bin_dict)
print(byte_str)

filename = input("\n\nfilename?\n")
if len(filename) > 0:
    filename = '_' + filename
with open(iso8601_utc_now() + filename + ".bin", 'wb') as outfile:
    outfile.write(bytes(byte_list))

"""
washes      value @
left        addr 0xa1

30          0x4e
.
.
.
16          0x40

15          0x5f
.
.
.
0           0x50


amusing values: 0x3f = 111 washes, 0x4f = 31 washes

"""
