dekuNukem/bob_cassette_rewinder/firmware/code/pmm.ioc

Mcu.UserName=STM32F042F6Px
PA0.GPIO_Label=LED_CARTOK
PA0.Signal=GPIO_Output
PA1.GPIO_Label=LED_DONE
PA1.Signal=GPIO_Output
PA11.Signal=USB_DM
PA12.Signal=USB_DP
PA13.Signal=SYS_SWDIO
PA14.Signal=SYS_SWCLK
PA2.Signal=USART2_TX
PA3.Signal=USART2_RX
PB8.GPIO_Label=USER_BUTTON
PB8.Signal=GPIO_Input
PF0-OSC_IN.Signal=I2C1_SDA
PF1-OSC_OUT.Signal=I2C1_SCL
