dekuNukem/bob_cassette_rewinder/pc_app/build_windows.py

import os
import sys

if 'win32' not in sys.platform:
    print("this script is for windows only!")
    exit()

# add C:\Program Files\7-Zip to windows environment variable first!
# or export PATH=$PATH:"C:\Program Files\7-Zip"

os.system('rm -rfv ./__pycache__')
os.system('rm -rfv ./build')
os.system('rm -rfv ./dist')
os.system('rm -rfv ./*.spec')

THIS_VERSION = None
try:
	mainfile = open('bob_util.py')
	for line in mainfile:
		if "THIS_VERSION_NUMBER =" in line:
			THIS_VERSION = line.replace('\n', '').replace('\r', '').split("'")[-2]
	mainfile.close()
except Exception as e:
	print('build_windows exception:', e)
	exit()

if THIS_VERSION is None:
	print('could not find version number!')
	exit()

os.system("pyinstaller.exe --noconsole bob_util.py")

output_folder_path = os.path.join('.', "dist")
original_name = os.path.join(output_folder_path, "bob_util")
new_name = os.path.join(output_folder_path, "bob_util_" + THIS_VERSION + "_win10_x64")

print(original_name)
print(new_name)

os.rename(original_name, new_name)
zip_file_name = "bob_util_" + THIS_VERSION + "_win10_x64.zip"
os.system('7z.exe a ' + zip_file_name + ' -r ' + new_name)

os.system('rm -rfv ./__pycache__')
os.system('rm -rfv ./build')
os.system('rm -rfv ./dist')
os.system('rm -rfv ./*.spec')
