dekuNukem/bob_cassette_rewinder/(commit log)

2021-03-17 done pcb
    [pmm.brd, pmm.sch]
2021-03-29 before timer
2021-04-01 fixed card edge connector footprint
    [pmm.brd, pmm.sch]
2021-04-03 added url to pcb
    [pmm.brd]
2021-04-04 updated component values
    [pmm.brd, pmm.sch]
2021-04-10 now rewinds rock'n'roll cassettes correctly
    [main.c]
2021-05-02 Fix link to Duckypad repo
    It's currently pointing to daytripper.
2021-12-18 minor adjustments on PCB
    [pmm.brd, pmm.sch]
2024-11-04 updated pcb for next production run
    [pmm.brd, pmm.sch]
