dekuNukem/bob_cassette_rewinder/(notices)

Notices in the files:
firmware/code/Src/main.c:
(C) COPYRIGHT STMicroelectronics *****END OF FILE
parts and their libraries:
SparkFun-Passives: Licensing: Creative Commons ShareAlike 4.0 International - https://creativecommons.org/licenses/by-sa/4.0
